uavcamera/uavcamera/schematics/images/layout/payload_smt_layout.jpg

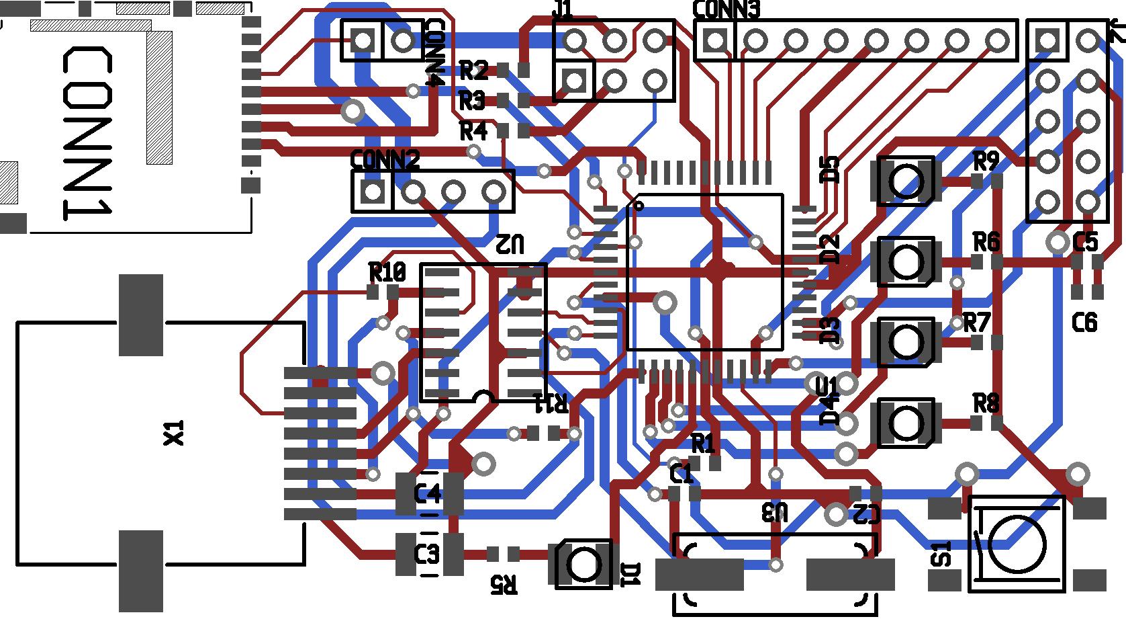
schematics/images/layout/payload_smt_layout.jpg
