uavcamera/uavcamera/documents/finalpresentation/GDP Group 18 pres.pptx

## GDP Group 18

Unmanned Aircraft Camera Module

Notes: Michael Start
Welcome

## The Next 20 Minutes

- Recap
- Specification and Progress Overview
- Implementation
- Testing
- Demo
- Evaluation
- Future Work
- Conclusion
- Questions

Notes: Michael
Describe our project: problem, specification, etc
How we’ve managed the project so far
Progress
Future plans

## Recap

Notes: Michael

## Problem

- Currently, an autopiloted UAV may take pictures while it is in the air
- On many UAV systems the aircraft must land before images can be downloaded and viewed
- These images could be inadequate
- Wireless transmission of images preferred

Notes: Michael

## SkyCircuits Autopilot (SC2)

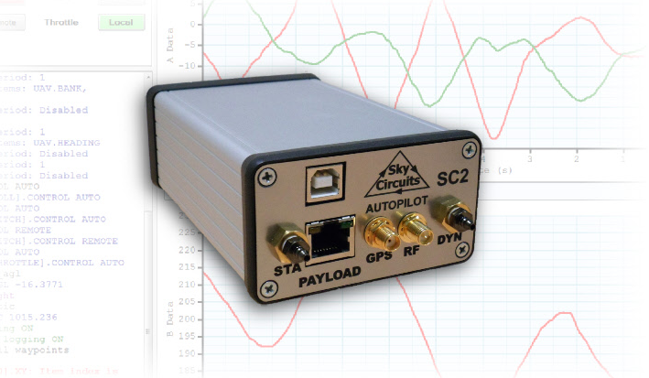
[picture p2: figure]

http://www.skycircuits.com/

Notes: Michael

## Specification & Progress Overview

Notes: John

## Block Diagram

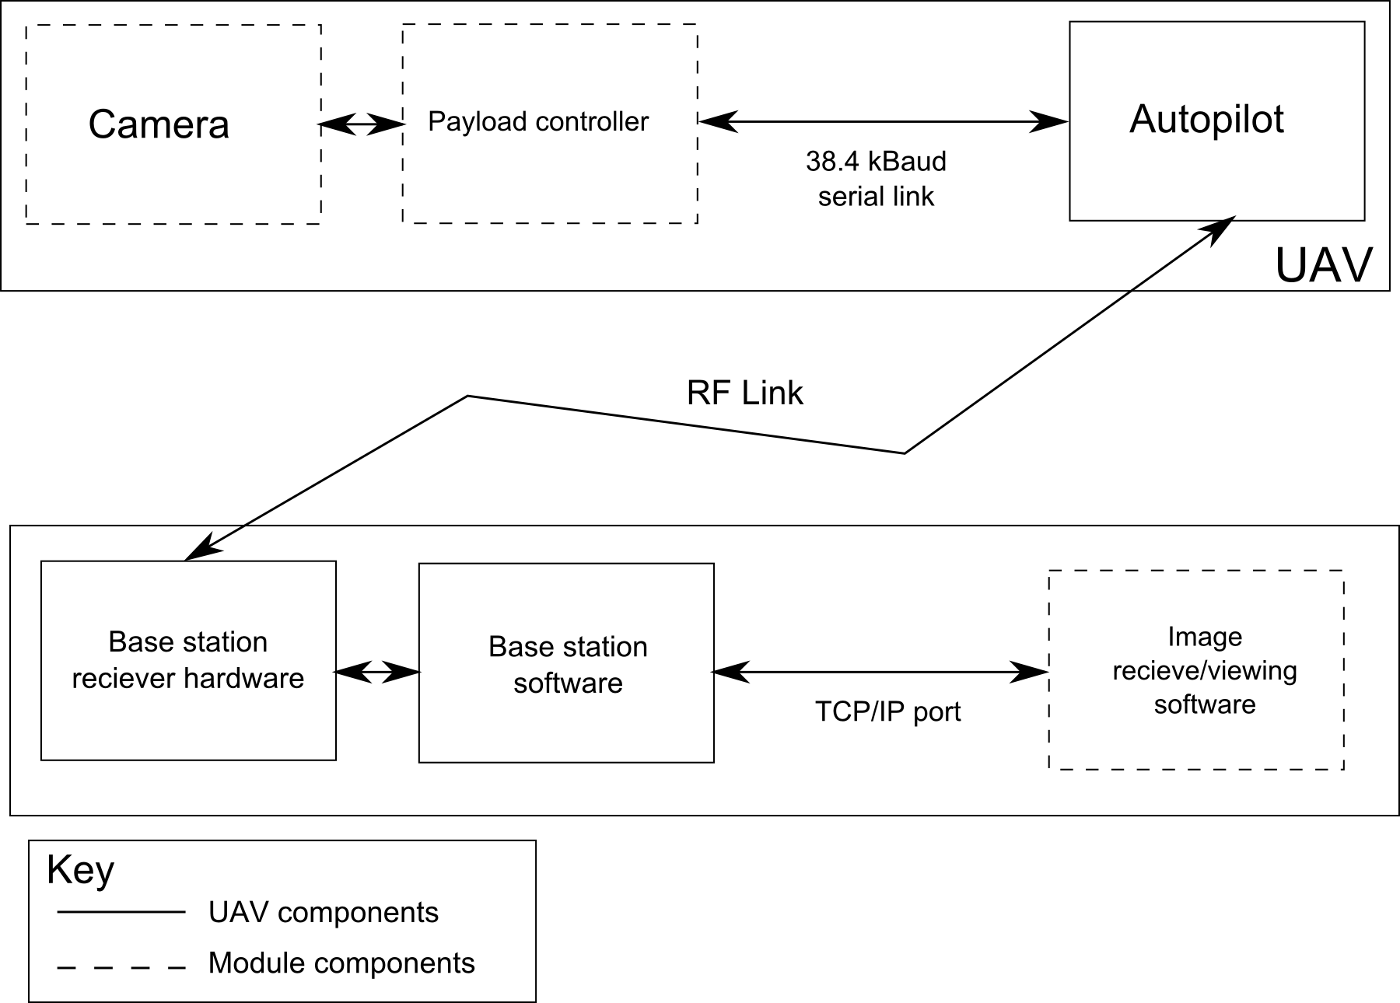
[picture p3: figure]

Notes: John“To design, build and test an electronic module capable of capturing still images from an unmanned aerial vehicle (UAV) and transmitting the images to a base station. The module must use the UAV autopilot’s low-bandwidth RS485 serial link (38.4 kBaud). A program must be written to interface with the base station software over a TCP/IP link, allowing image data to be received and displayed to the user. The electronic module will be constructed using strip-boards and will later be implemented on PCB if time is available.

## Spec: High Priority

- Prompt (from base station) to capture and download image
- Progressive Image encoding/decoding
- Minimise download time (less than 3 minutes)

Notes: John

## Spec: High Priority

- ~~Prompt (from base station) to capture and download image~~
  - GUI functional
- Progressive Image encoding/decoding
  - Lowered in priority, some code written
- ~~Minimise download time (less than 3 minutes)~~
  - Approximately 1 minute download for 640x480 (dependent on packet loss)

Notes: John

## Spec: Medium Priority

- Module weight < 250g
- Image resolution: 640 x 480
- Cancel image download whilst downloading

Notes: John

## Spec: Medium Priority

- ~~Module weight < 250g~~
  - ~70g
- ~~Image resolution: 640 x 480~~
- ~~Cancel image download whilst downloading~~

Notes: John

## Spec: Low Priority

- Resend an image if corrupted
- Interrupt download of image, save incomplete image
- Select resolution of image
- Display progress indicator of download
- (User defined) Automatic image capture
- Colour images
- Select between colour / BW

Notes: John

## Spec: Low Priority

- ~~Resend an image if corrupted~~
  - Automatic Repeat reQuests (ARQ)
- ~~Interrupt download of image, save incomplete image~~
- ~~Select resolution of image~~
- ~~Display progress indicator of download~~

Notes: John

## Spec: Low Priority (cont.)

- ~~(User defined) Automatic image capture~~
  - Autopilot script triggers on waypoints, height, etc.
- ~~Colour images~~
- Select between colour / BW

## Spec: Deliverables

- Hardware: Constructed camera module
- Software: Firmware for module, Software for base station
- Documentation: Technical and User Documentation
- Public Repository: Open source, publically accessible repository, includes all the above

Notes: John

## Spec: Deliverables

- Hardware: ~~Constructed camera module~~
  - All on PCB
- Software: ~~Firmware for module~~, ~~Software for base station~~
- Documentation: ~~Technical and User Documentation~~
- Public Repository: ~~Open source~~, ~~publically accessible repository~~, ~~includes all the above.~~
  - https://github.com/uavcamera/uavcamera

Notes: John

## Implementation

## Ground Station -> Payload Communication

- Autopilot -> Payload comms: Message sending

Autopilot

Message

Payload

Ground Station

Our GUI

Console Port

## Ground Station <- Payload Communication

- Payload -> Autopilot comms: Shared memory

Autopilot

Shared memory

Our GUI

Ground Station

Payload

Data Port

## Commands

- 10 Commands
- Uses Automatic Repeat reQuest (ARQ)
- E.g. Image Download Request:
  - 0x02 0xXX 0xXX

Command ID

Image ID to Download (LSB)

Image ID to Download (MSB)

## Camera Communication

- JPEG images at:
  - 80 x 64
  - 168 x 128
  - 320 x 240
  - 640 x 480
- SD card used as storage

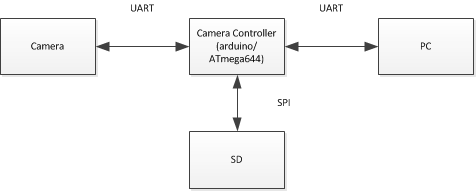
[picture p4: figure]

Autopilot

## Physical Implementation

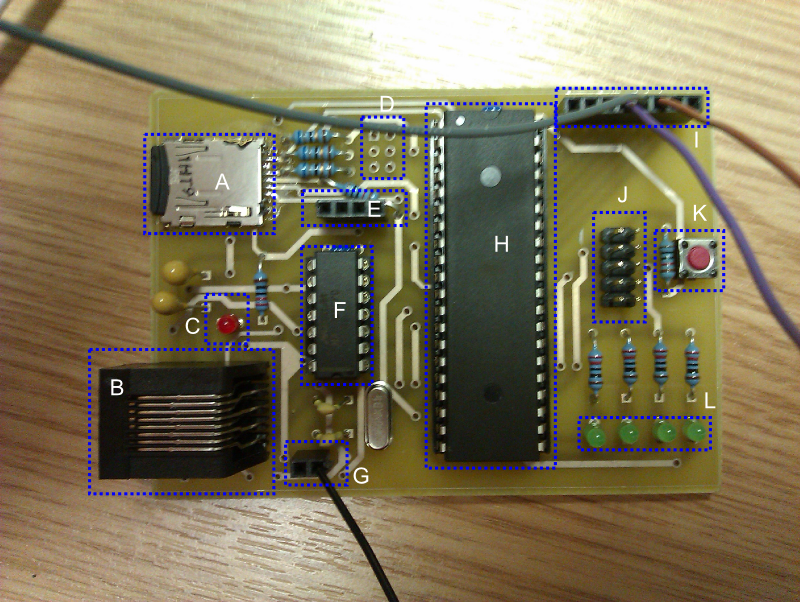
[picture p5: figure]

## Tools Used

- C# .NET for GUI (Visual Studio 2010)
- C++ (including Sanguino libraries) Eclipse
- MATLAB for progressive image testing
- gEDA for schematics/PCB layouts
- Git for version control

## Cost to Reproduce

| Through Hole | Surface Mount
PCB (15 day, PCBtrain, ex. Delivery) | £33.08 | £33.08
Components (Farnell, inc. VAT, delivery) | £22.63 | £25.84
Camera (inc. VAT, ex. Delivery) | £52.80 | £52.80
TOTAL* | £108.51 | £111.72

* one-off production

## Testing

## Debugging

- Implemented simple debug interface for payload over SPI
- Testing central to debugging implementation

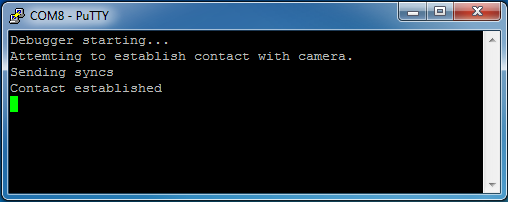
[picture p6: figure]
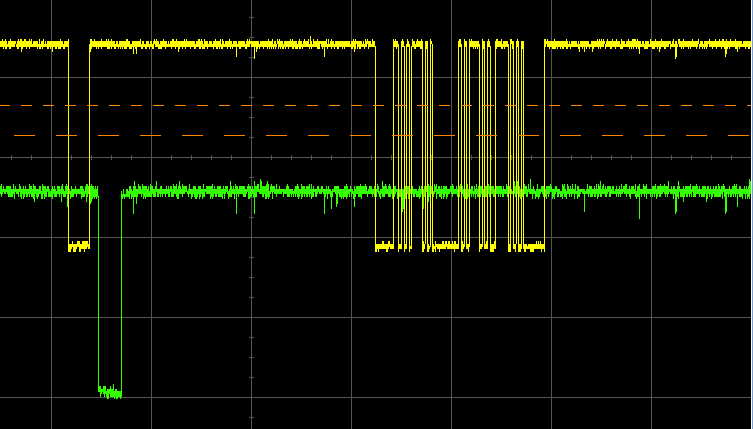
[picture p7: figure]

## Test Plan

- Iterative testing during implementation

Design

Test

Prototype

## Camera Testing

Establishing Contact

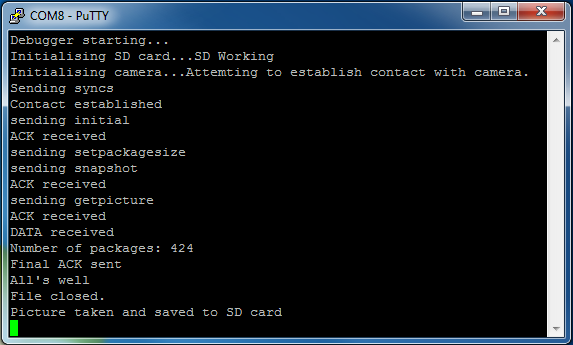
[picture p8: figure]
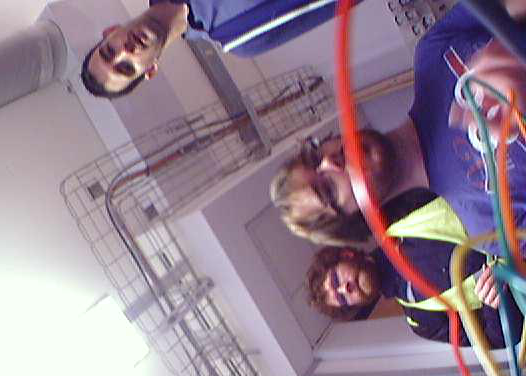
[picture p9: figure]

Getting Image

## Payload to Autopilot Communications Testing

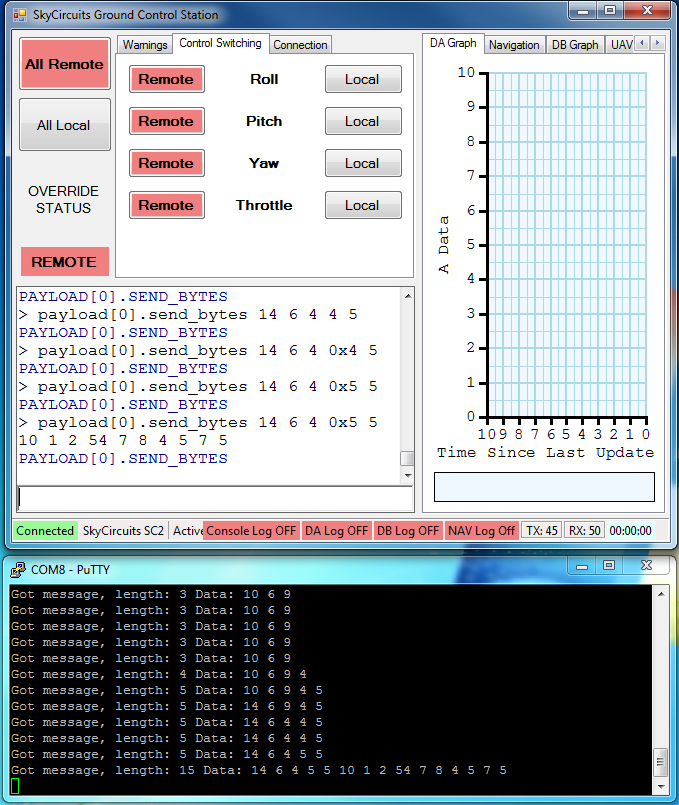
[picture p10: figure]

Setting Shared memory
and Sending Messages

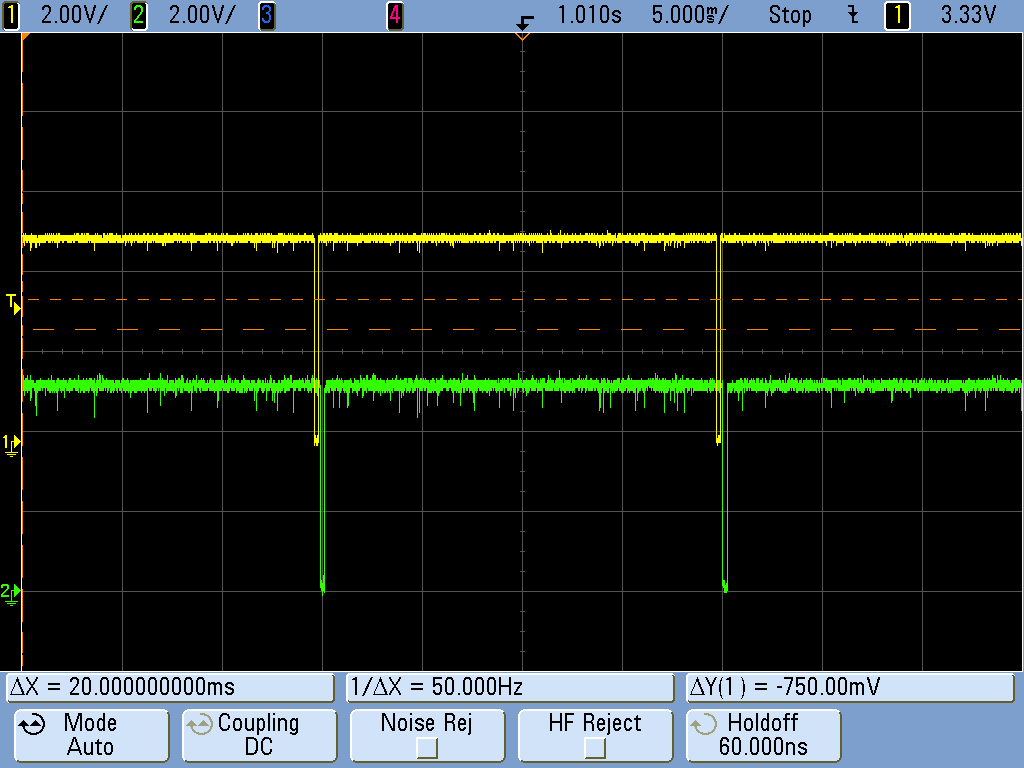
[picture p11: figure]

Basic Connection
(Tx Tokens)

Image Sending
Over Autopilot Link

Reliable Transmission using ARQs

## Ground Station Software Testing

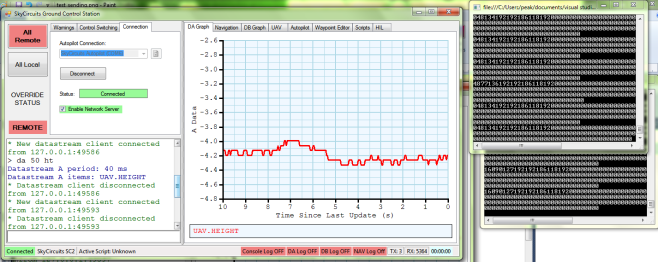
[picture p12: figure]

Streaming Data from
SkyCircuits Software

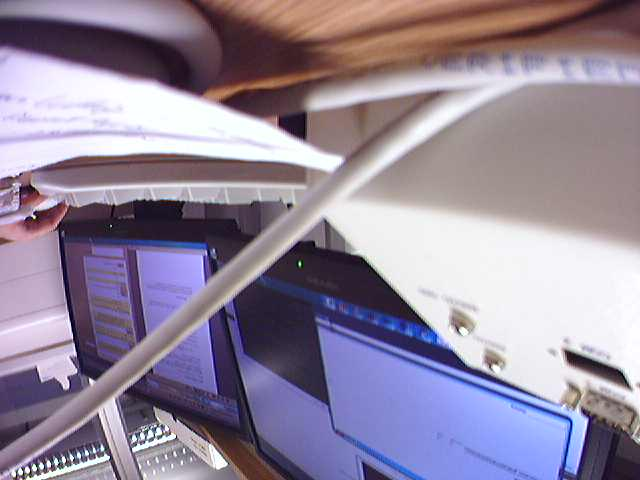
[picture p13: figure]

Basic Image Download via Autopilot Link

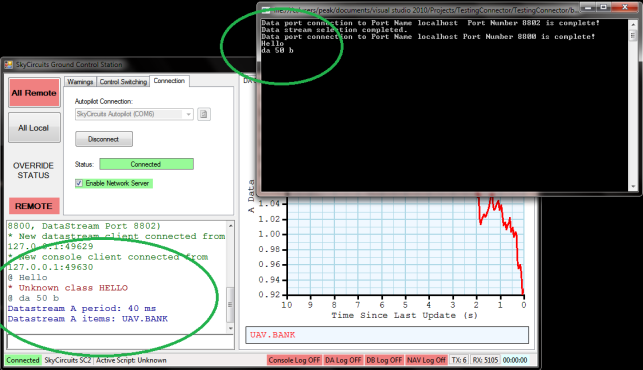
[picture p14: figure]

Sending Command to
SkyCircuits Console Port

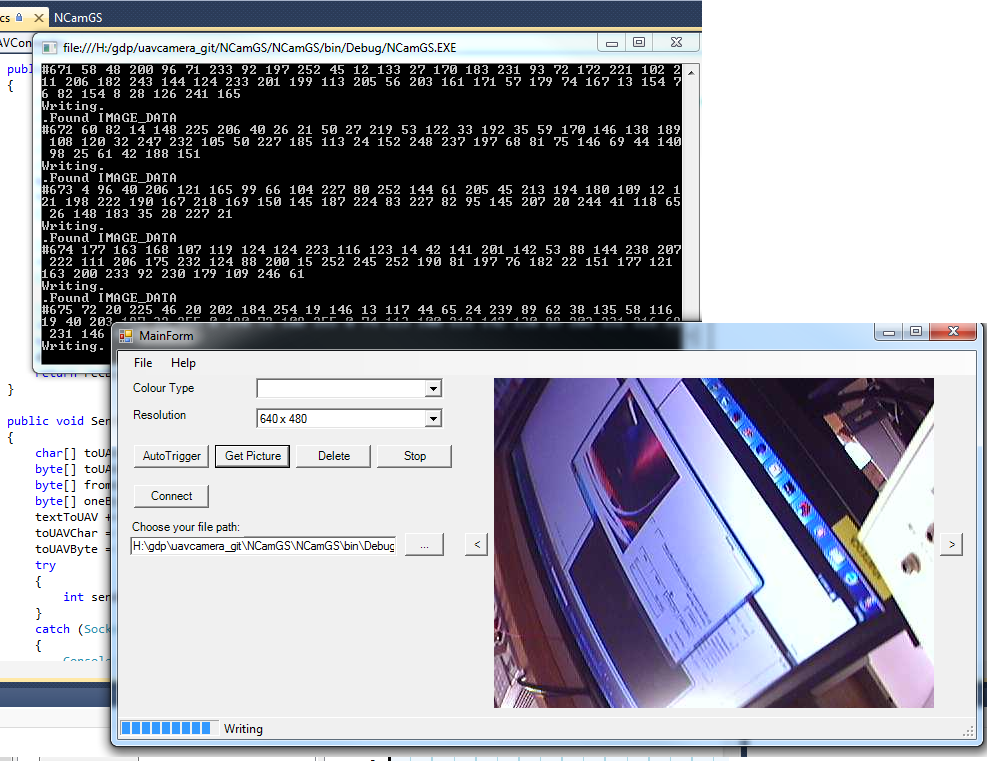
[picture p15: figure]

Image Capture and Download Using GUI

## ARQ Testing

- Packet loss simulated
  - 1 in 100 probability of packet dropping.
  - Software resent commands and image data that were not acknowledged.

## JPEG Header Extractor Testing

- DCT and Huffman tables extracted
- Extraction results compared with open source model (JPEGsnoop)
- Tested against a variety of 640x480 images

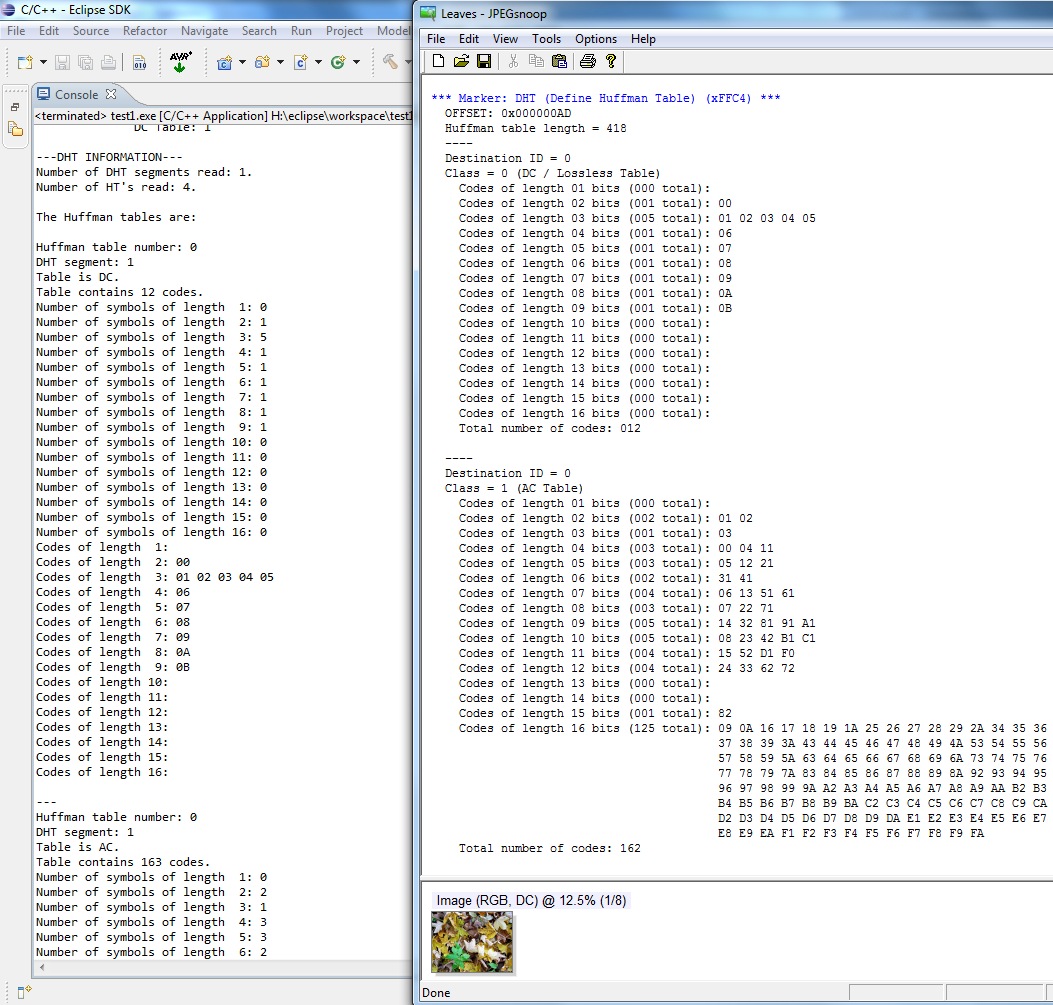
[picture p16: figure]

## Final Testing

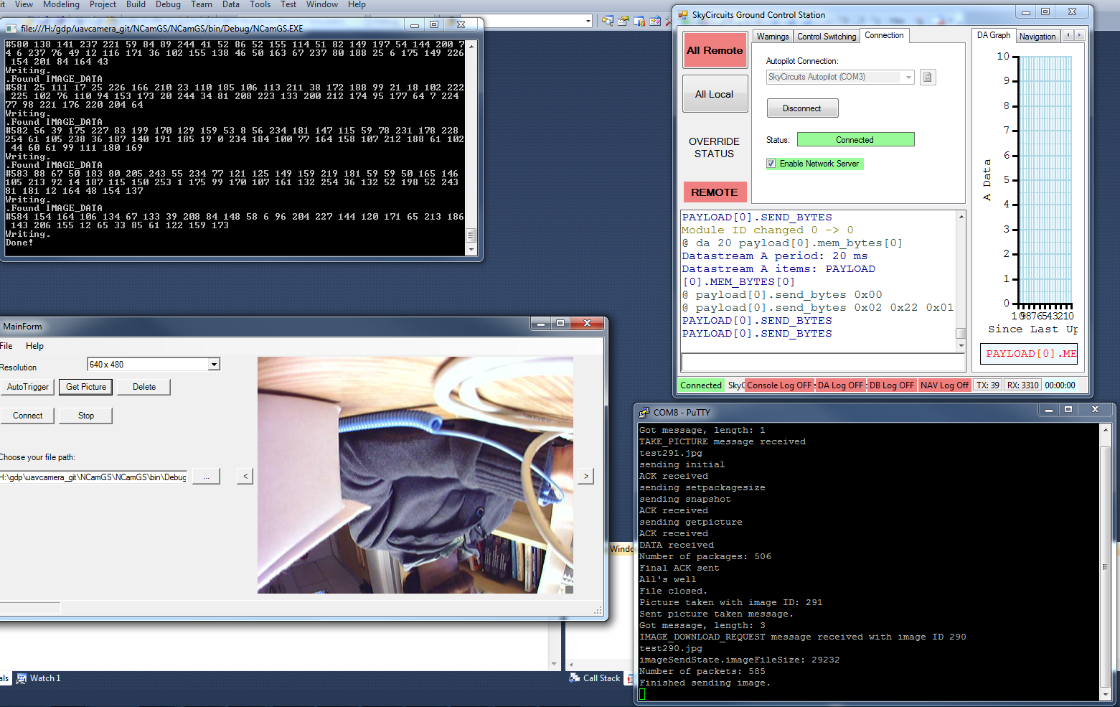
[picture p17: figure]

## Final Testing

- Speed (at 640x480) – No Dropped Packets:
  - ~8s Capture
  - ~60s Download (low packet loss)
  - ~70s Total
- Weight:
  - ~53g Without camera case
  - ~70g With camera case

## Demo

## Evaluation

## Streams

Acquired working camera

Got image off camera

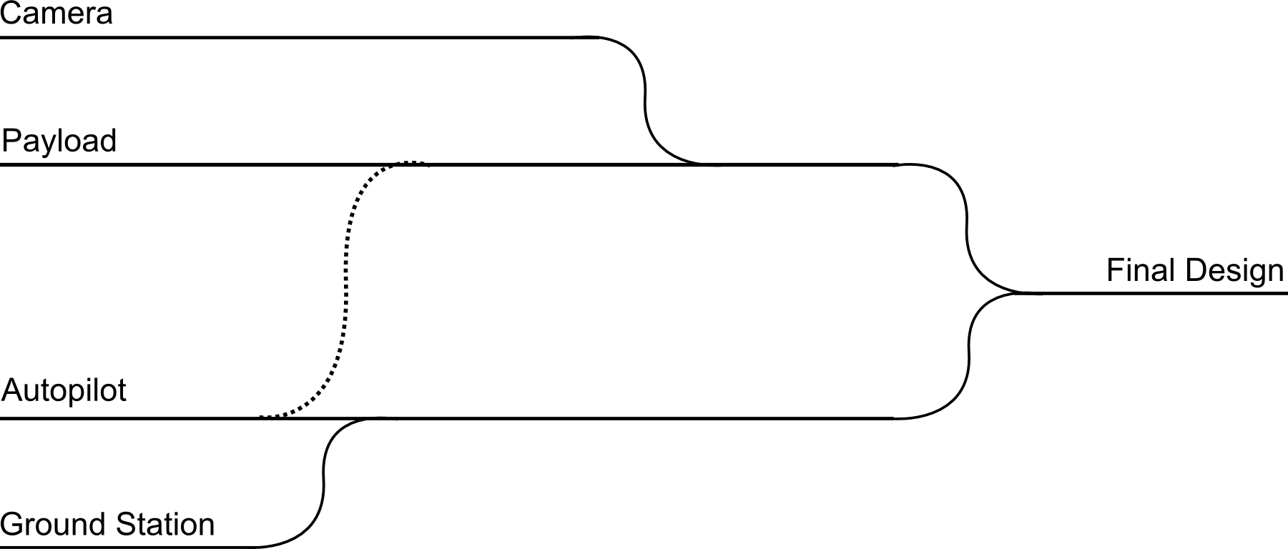
[picture p18: figure]

Payload communicating with camera

Payload communicating with autopilot

Working GUI

PCB Implementation

Our software communicating with Autopilot via GS software

Autopilot debugging

## Management

- Regular group meetings and progress reviews
  - Helped identify problems early
  - Minutes for when we needed to refer back to them
- Good Communication
  - Email, telephone, IRC, meetings, source control

## Obstacles

- Two camera failures
  - Ordered new cameras, modified project plan to fit around first delay, postponed flight test due to second.
- Bug in Autopilot code
  - Extensive debugging alongside supplier of autopilot.

## Future Work

- Progressive Image Transfer
- Multiple cameras at once (possibly 3D)
- Multiple types of camera
- Video Streaming
- SD file system access
- HDR Photography
- Image processing (e.g. for target fixation)

## Conclusion

## Conclusion

- As previously mentioned, most of specification was completed on time, under budget.
- Elements that weren’t completed, there’s a good reason for. Mostly low-priority tasks.
- We have delivered a working system to our customer.

## Questions?
