uavcamera/uavcamera/schematics/images/payload_smt.pdf

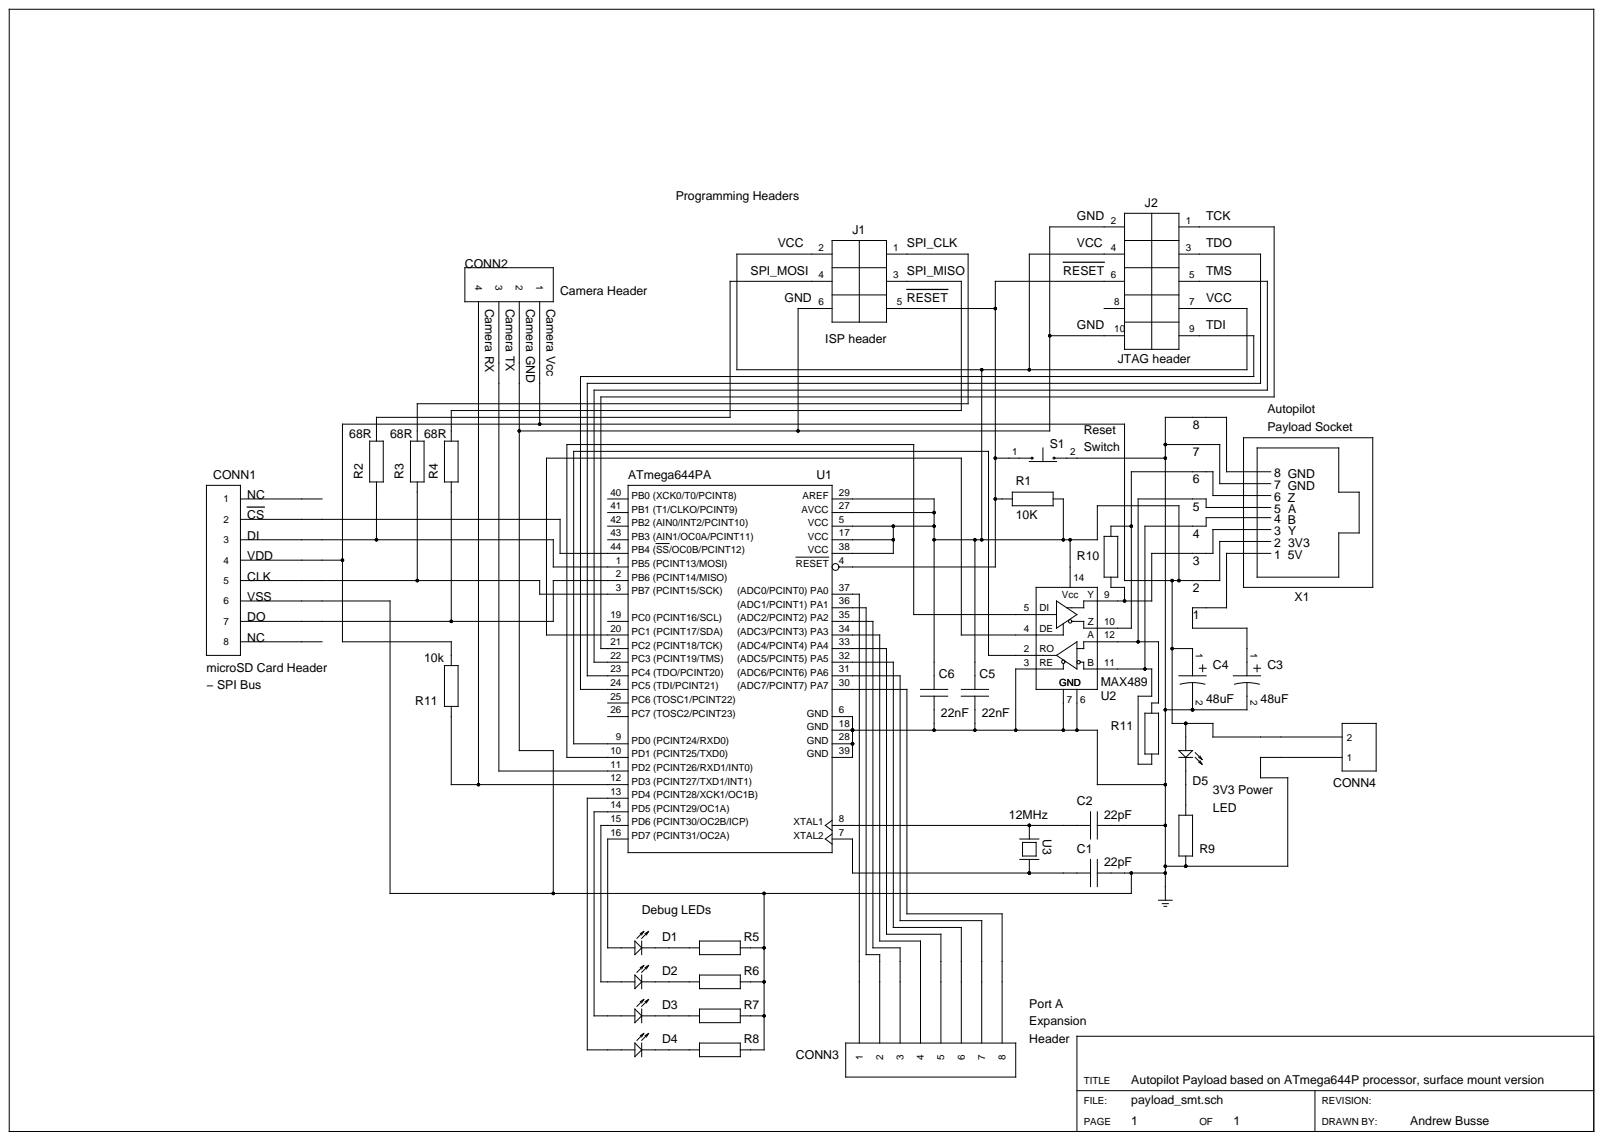
[picture p19: page 1]

Autopilot Payload based on ATmega644P processor, surface mount version
payload_smt.sch
