uavcamera/uavcamera/schematics/images/layout/payload_smt_layout.pdf

# payload_smt.pcb

# 1. Table of Contents (This Page) Created on Tue Jan 10 19:30:12 2012

# 2. component 3. solder 4. plated-drill 5. componentmask 6. soldermask 7. topsilk 8. bottomsilk 9. toppaste 10. topassembly 11. bottomassembly 12. fab

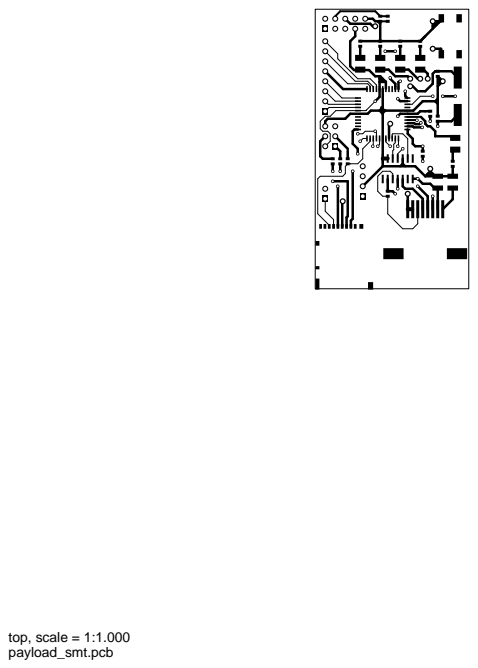
[picture p20: page 2]
top, scale = 1:1.000

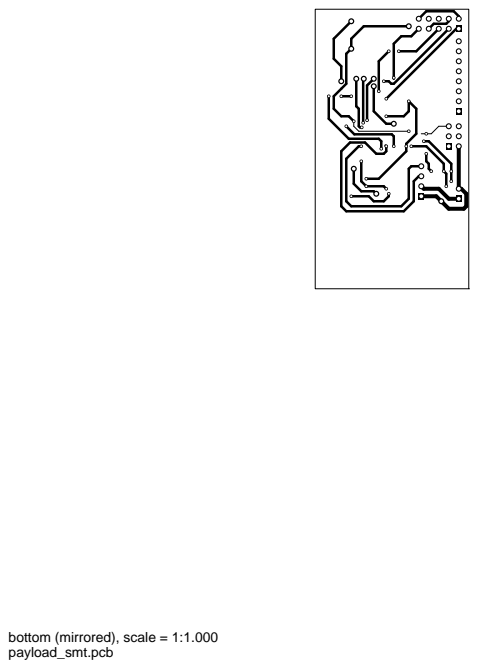
[picture p21: page 3]

bottom (mirrored), scale = 1:1.000

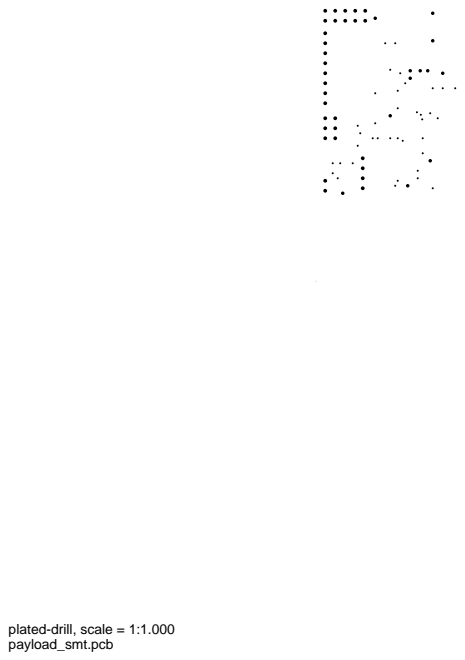
[picture p22: page 4]

plated-drill, scale = 1:1.000

topmask, scale = 1:1.000

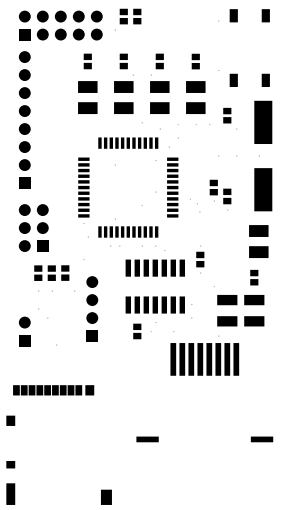
[picture p23: figure]

bottommask (mirrored), scale = 1:1.000

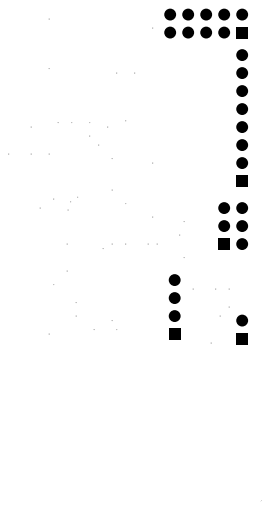
[picture p24: figure]
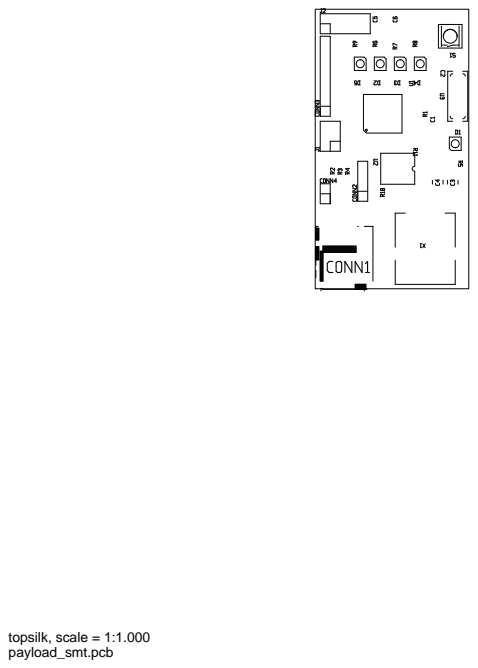
[picture p25: page 7]
topsilk, scale = 1:1.000

bottomsilk (mirrored), scale = 1:1.000

toppaste, scale = 1:1.000

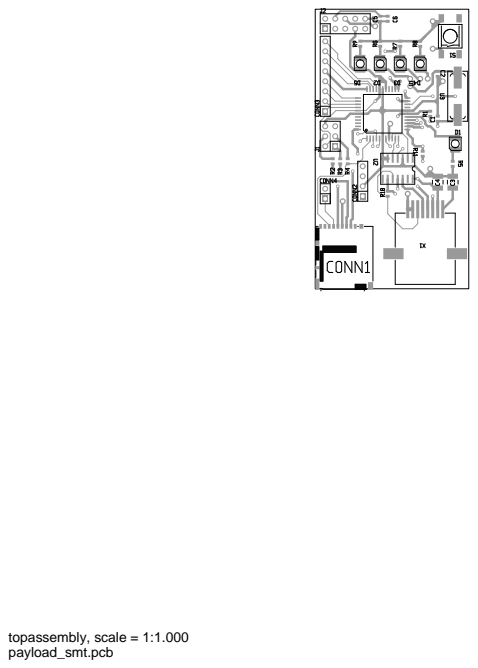
[picture p26: page 10]
topassembly, scale = 1:1.000

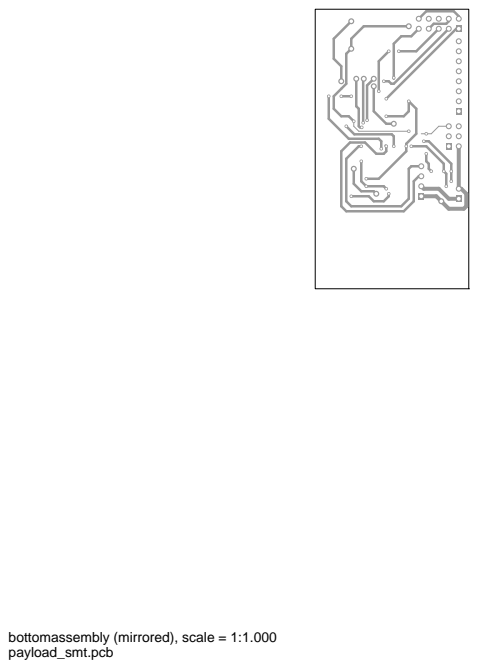
[picture p27: page 11]

bottomassembly (mirrored), scale = 1:1.000

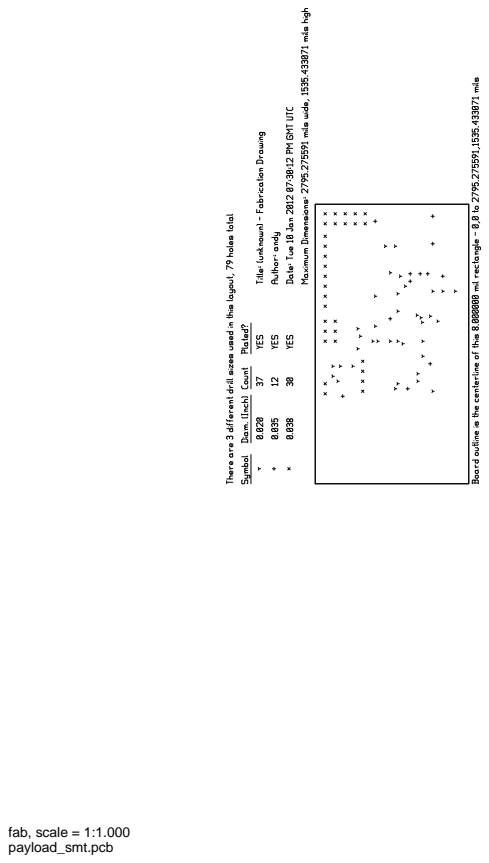
[picture p28: page 12]
fab, scale = 1:1.000
