uavcamera/uavcamera/(list of files, drawings)

Other design files:
schematics/payload_smt.pcb
