uavcamera/uavcamera/(commit log)

2011-12-06 WIP for wireless ack
2012-01-10 Shave board size down to 71mm * 39mm
    [payload_smt.pcb]
2012-01-10 Add Farnell baskets for both of the final boards
    [basket_644.csv, basket_smt.csv]
2012-01-10 Move gerber files into a new subdirectory
    This is so that the through hole and surface mount gerbers are
    in distinct places
    [payload_644.bottom.gbr, payload_644.bottommask.gbr, payload_644.bottompaste.gbr, payload_644.bottomsilk.gbr, payload_644.fab.gbr, payload_644.group3.gbr, payload_644.group4.gbr, payload_644.group5.gbr]
2012-01-10 Add all of the gerbers related to the SMT component PCB
    [payload_smt.bottom.gbr, payload_smt.bottommask.gbr, payload_smt.bottompaste.gbr, payload_smt.bottomsilk.gbr, payload_smt.fab.gbr, payload_smt.group3.gbr, payload_smt.group4.gbr, payload_smt.group5.gbr]
2012-01-10 Slightly modify surface mount border text.
    [payload_smt.sch]
2012-01-10 Add some images of the surface mount schematic.
    Very minor difference to the payload_644 stuff.
2012-01-10 Add a README for the schematic/ folder.
    Hopefully, this renders in github markdown.
2012-01-10 Misc fixes of ack stuff
    [image_sender.h, packet_scan.cpp, packet_scan.h]
2012-01-10 stop errors due to open image file if download stopped prematurley
    [packet_scan.cpp]
